lpender3672/IDP_M213/README.md

# IDP_M213
Group M13's repository for IB Integrated Development Project
