lpender3672/IDP_M213/src/r.png

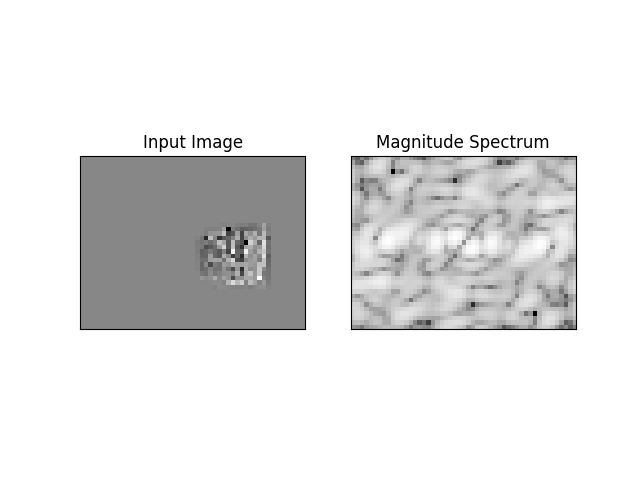
src/r.png
