lpender3672/IDP_M213/src/calibrate/Screenshot_20221121_095116.png

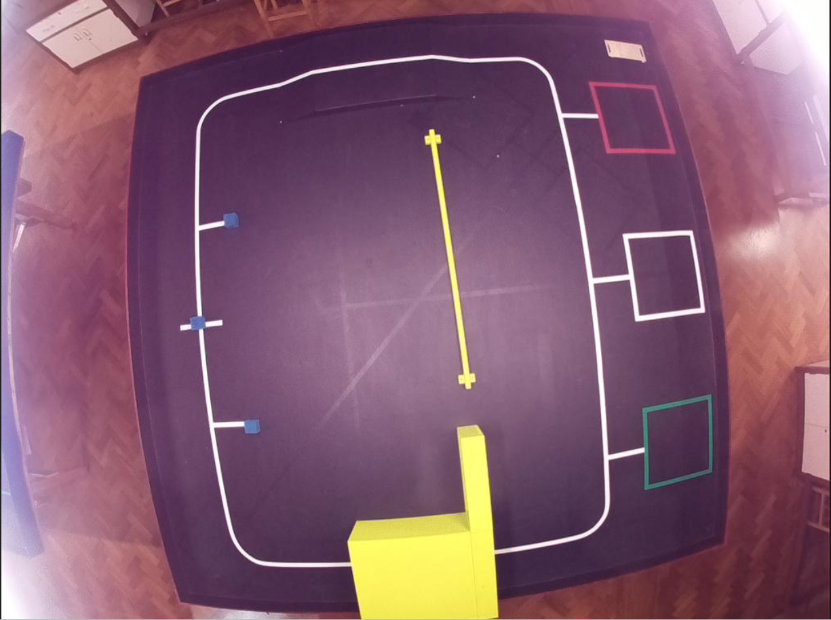
src/calibrate/Screenshot_20221121_095116.png
