lpender3672/IDP_M213/src/calibrate/vlcsnap-2022-11-21-10h47m11s677.png

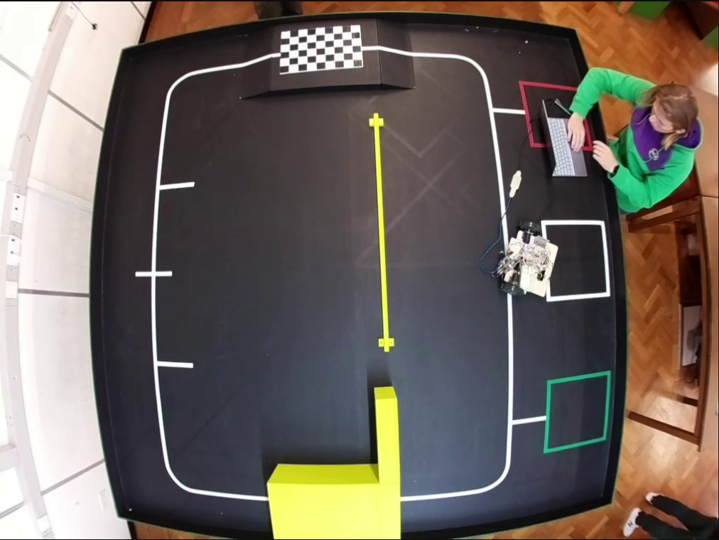
src/calibrate/vlcsnap-2022-11-21-10h47m11s677.png
