lpender3672/IDP_M213/src/calibrate/vlcsnap-2022-11-21-10h48m04s807.png

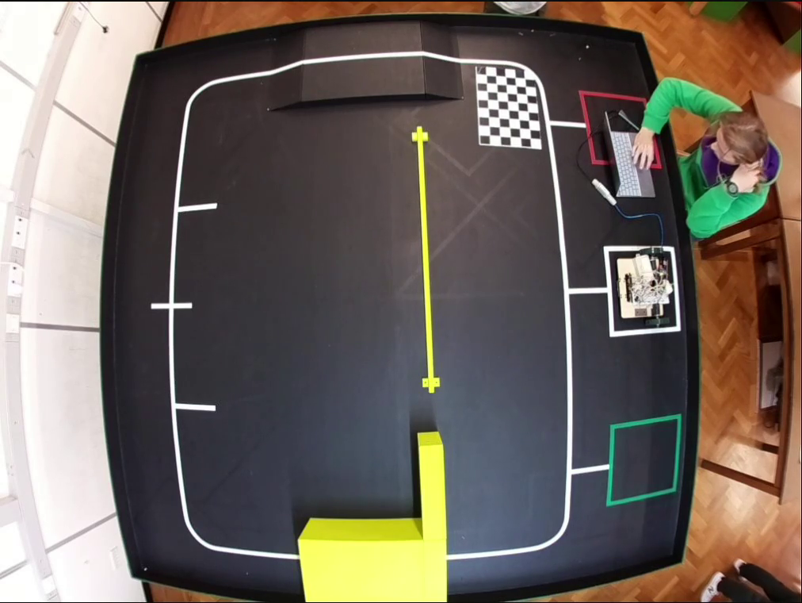
src/calibrate/vlcsnap-2022-11-21-10h48m04s807.png
