lpender3672/IDP_M213/src/Arduino/IDP.ino

#define SECRET_SSID "YOUR SSID HERE"
#define SECRET_PASS "YOUR PASSWORD HERE"

#include <SPI.h>
#include <WiFiNINA.h>

char ssid[] = SECRET_SSID;        // your network SSID (name)
char pass[] = SECRET_PASS; 

int status = WL_IDLE_STATUS;

WiFiServer server(80);

void setup() {
  Serial.begin(9600);

  // attempt to connect to WiFi network:
  while (status != WL_CONNECTED) {
    Serial.print("Attempting to connect to SSID: ");
    Serial.println(ssid);
    // Connect to WPA/WPA2 network. Change this line if using open or WEP network:
    status = WiFi.begin(ssid, pass);

    // wait 10 seconds for connection:
    delay(10000);
  }
  server.begin();
  // you're connected now, so print out the status:
  printWifiStatus();

}

void loop() {
  WiFiClient client = server.available();
    if (client) {
    Serial.println("new client");
    // an HTTP request ends with a blank line
    boolean currentLineIsBlank = true;
    while (client.connected()) {
      if (client.available()) {
        char c = client.read();
        // Serial.write(c);
        // if you've gotten to the end of the line (received a newline
        // character) and the line is blank, the HTTP request has ended,
        // so you can send a reply
        if (c == '\n' && currentLineIsBlank) {
          // send a standard HTTP response header
          client.println("HTTP/1.1 200 OK");
          client.println("Content-Type: text/html");
          client.println("Connection: close");  // the connection will be closed after completion of the response
          client.println();
          break;
        }
        if (c == '\n') {
          // you're starting a new line
          currentLineIsBlank = true;
        } else if (c != '\r') {
          // you've gotten a character on the current line
          currentLineIsBlank = false;
          char buf[128] = "";
          buf[0] = c;
          int currIdx = 1;
          while (c != '\n'){ //wait for line end
            c = client.read();
            buf[currIdx] = c;
            currIdx++;
          }
          currentLineIsBlank = true;
          Serial.write(buf);
          }
        }
      }
    }
    // give the web browser time to receive the data
    delay(1);

    // close the connection:
    client.stop();
    // Serial.println("client disconnected");

}

void printWifiStatus() {
  // print the SSID of the network you're attached to:
  Serial.print("SSID: ");
  Serial.println(WiFi.SSID());

  // print your board's IP address:
  IPAddress ip = WiFi.localIP();
  Serial.print("IP Address: ");
  Serial.println(ip);

  // print the received signal strength:
  long rssi = WiFi.RSSI();
  Serial.print("signal strength (RSSI):");
  Serial.print(rssi);
  Serial.println(" dBm");
}
