lpender3672/IDP_M213/(commit log)

2022-11-05 inlcuding fix from https://github.com/arduino/arduino-cli/issues/6
2022-11-05 theres a command called arduino-cli core update-index
2022-11-05 change of board arg
2022-11-05 should work now theres not much information about arduino fqbn out there
2022-11-09 path corner temporal filtering
2022-11-11 filtering done
2022-11-18 start Arduino
